calsfu/AutonomousTrike/trike/test/carla_scripts/data/test.png

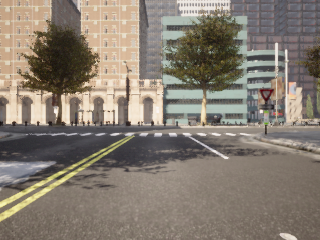
trike/test/carla_scripts/data/test.png
