calsfu/AutonomousTrike/hardware_sup/BrakePicture.png

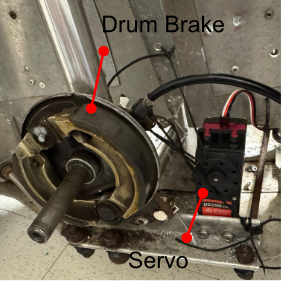
hardware_sup/BrakePicture.png
