calsfu/AutonomousTrike/docs/reports/2nd Semester Prototype Plan.docx

# Memo

To: Professor Pisano

From: Linden Adamson, Jason Calalang, Tara Gill, Zhilang Gui, Cole Resurreccion, Raina Yin

Team: Team 7 - Bike for Blind

Date: 02/22/2025

Subject: Second Prototype Testing Plan

Boston University

Electrical & Computer Engineering

EC464 Senior Design Project

Second Prototype Testing Plan Report

Blind Bike


By

Team 7

Bike for Blind

Team Members

Linden Adamson lindena@bu.edu

Jason Calalang jasonc16@bu.edu

Tara Gill taragill@bu.edu

Zhilang Gui zgui@bu.edu

Cole Resurreccion coler@bu.edu

Raina Yin ryin2@bu.edu

Required Materials/Equipment

Hardware:

- Jetson Orin Nano Super Developer Kit
- OAK-D RGBD Camera
- LED Strips - Brake Lights (5V, 8W)
- 2x DS5160 60 kg*cm Servo Motor
- PCA9685 Motor Driver
- NFP-36GP-555-EN 24V Geared Motor
- DC Motor Driver L298 Dual H Bridge Motor
- 19V 4.2A Barrel Jack Power Supply
- Arduino Uno R3
- Arduino Nano
- Keysight E36318 Triple Output Power Supply
  - 6V for braking
  - 24V for steering

Software:

- Arduino Code
  - Steering script - flashed to Arduino Nano
  - Brake and Key Fob script- flashed to Arduino Uno
- Emergency Stop with Stereo Camera Demo
- Manual Stop Button
- Orin Nano ROS2 Nodes
  - Keyboard Operation (for control)
  - Braking Command
  - Steering Command
  - OAK-D ROS2 Nodes
  - Vectornav

Set-Up

First, every component must be wired according to the diagram below.

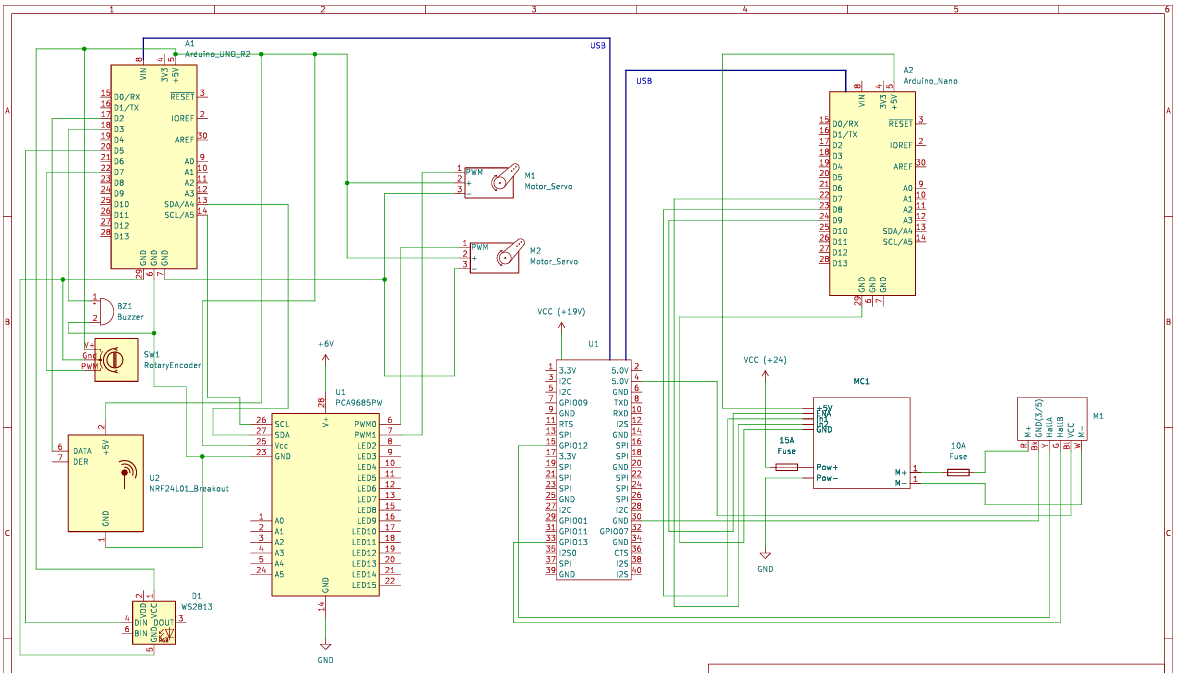
[picture p5: figure]

Figure 1: Circuit Schematic of Prototype System

Once all the components are appropriately connected, ensure no exposed wires are making contact with the aluminum frame to cause a short. After confirming connections, provide power to the necessary components.

- Arduino Nano and Uno should be getting power from the USBs provided by the Orin.
- Connect the 6V output from the power supply to the PCA9685 servo driver.
- Connect the higher voltage output from the power supply to the motor controller and set the output to 24V.
- Power the Orin with the 19V barrel jack plug.
- The LED strip should be powered from the 5V pin on the Arduino.
- The OAK-D should be powered from an Orin USB port.

For proper braking tests, at least one of the DS5160 servo motors should be mounted and attached to the trike.

For the braking system test, the Arduino Uno will be connected to the Jetson Orin. The LED strips and PCA9685 motor driver will be connected to the Arduino Uno. The DS5160 servo motors will both be connected to the PCA9685 motor driver, with one servo motor mounted onto the trike’s brake pad.

For the key fob, a 433MHz RF receiver and a 96dB Piezo buzzer will be connected to the Arduino Uno.

For the steering system, a belt loop should be connected to the main steering joint and the motor output shaft. The NFP should be plugged into the controller and the encoder output should be attached to the Arduino.

For object detection, an OAK-D camera will be mounted onto the trike and connected to the Orin.

Pre-testing Setup Procedure:

On Orin Nano:

1. Open four terminals on the Orin Nano. Run the following commands on those terminals.
  a. ros2 run tester key_op
  b. ros2 launch trike main_launch.py
  c. ros2 run tester emergency_stop
  d. rqt

Power Supply

1. Set the +/-24 V Output of the power supply to +24 V.
2. Set the 6V Output of the power supply to 6V

Testing Procedure:

The testing procedure should mimic a person using the trike.

1. Stand 10m away from the trike and use the keyfob by pressing RF button transmitter and hearing the sound from the buzzer to find the trike.
2. On the keyboard operation terminal:
  a. Type the character s. The brakes should engage and the LED brake lights should turn on.
  b. Type the character w. The brakes should disengage and the LED brake lights should turn off.
  c. Type the character j. The steering motor should turn left.
  d. Type the character k. The steering motor should stop.
  e. Type the character l. The steering motor should turn right.
3. Activate emergency braking software
  a. Clear OAK-D camera’s sightline of any object 2m or closer. The brakes should not be engaged.
  b. Walk to within 2m of the OAK-D camera. The brakes should engage.
  c. Leave 2m sightline of OAK-D camera. The brakes should disengage.
4. Manual brake
  a. Press the manual brake button on the inside of the vehicle. The brakes should engage.
5. Repeat each of the above testing procedures 5 times to prove consistent accuracy of our system.

Measurable Criteria

1. Key fob will activate the buzzer at least 10 meters away from the trike with 80% accuracy.
2. Brake lights and brakes engage within 0.1s of receiving brake command from the Orin Nano with 100% accuracy.
3. Brakes will engage when an object is within 2m of OAK-D camera sightline, and disengage when there is no object within 2m of OAK-D camera sightline with 90% accuracy.
4. Manual brake button will engage the brakes with 100% accuracy. The system should confirm full brake engagement within 0.2 second. It should also override the braking command from the emergency brake.
5. Brake servo motors rotate enough to engage the brake pad with 100% accuracy. The response time should not exceed from command issuance to brake engagement must not exceed 0.2 second.
6. The steering motor will rotate in response to the motor command from the Orin, and the rotation angle must match the command input within the tolerance of 2 degrees to ensure accurate steering.
7. The steering motor restricts itself to rotate within a 60-degree range.

Senior Design ENG EC 464
