calsfu/AutonomousTrike/docs/schematics/Trike HW_SW.drawio.png

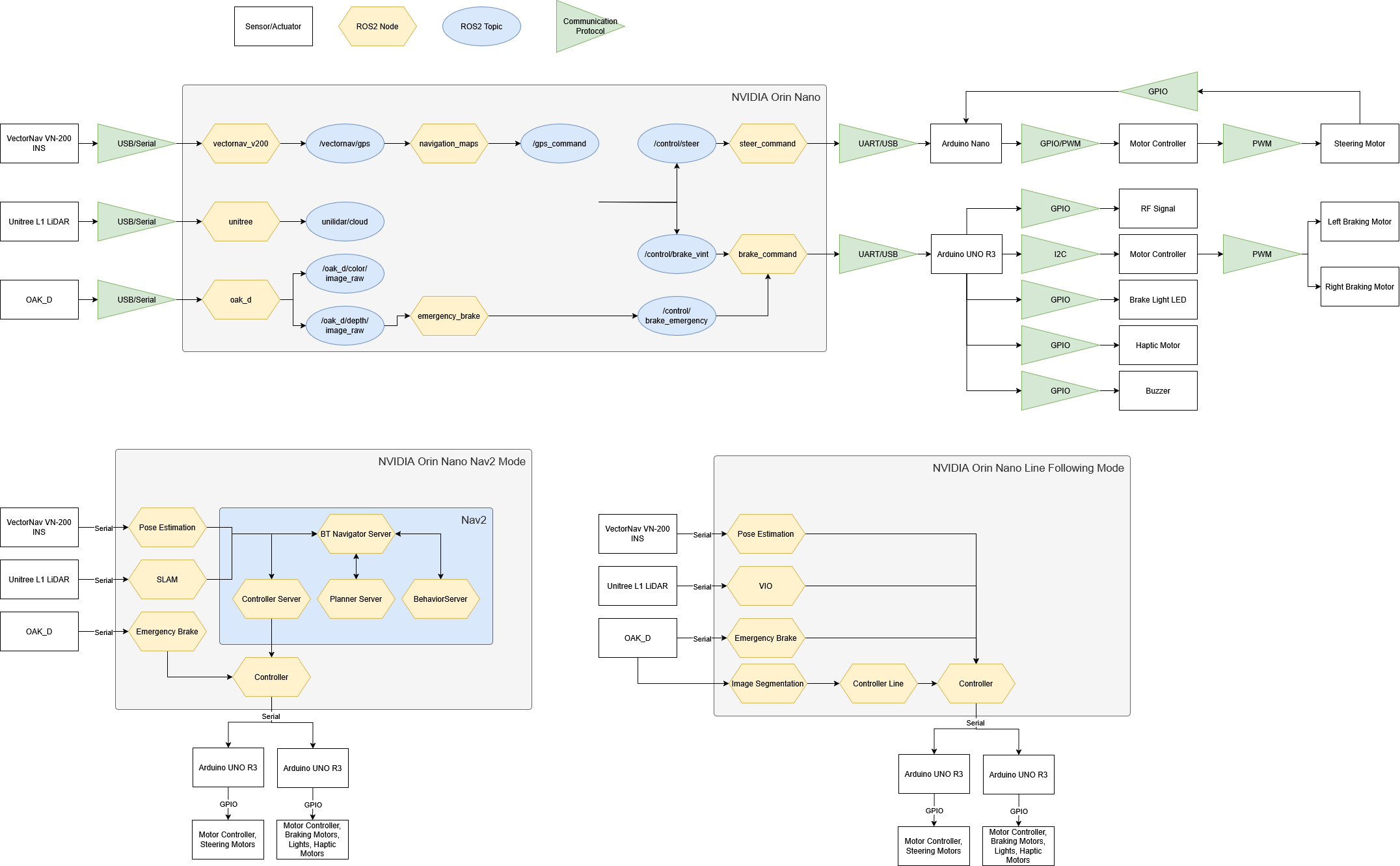
docs/schematics/Trike HW_SW.drawio.png
