calsfu/AutonomousTrike/hardware_sup/EnclosurePicture.jpg

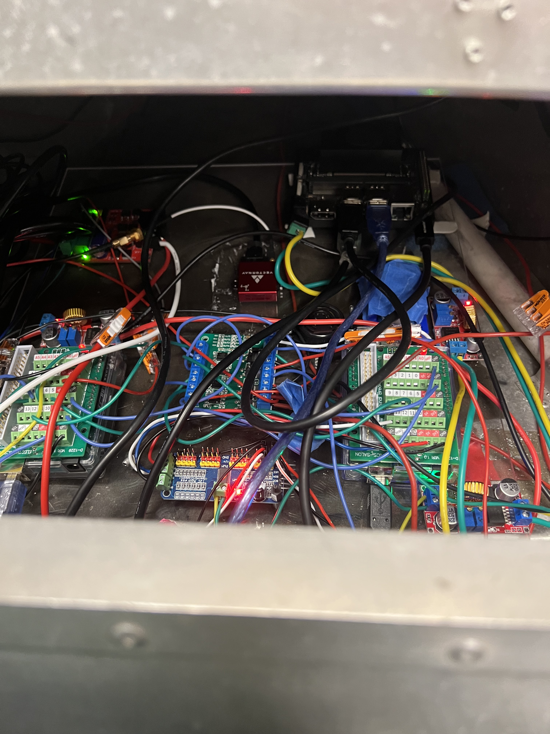
hardware_sup/EnclosurePicture.jpg
