calsfu/AutonomousTrike/hardware_sup/MotorPicture.png

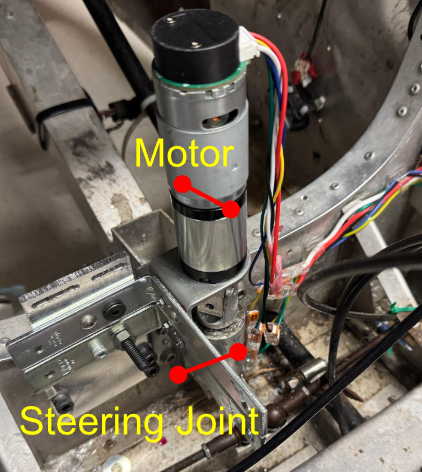
hardware_sup/MotorPicture.png
