calsfu/AutonomousTrike/trike/map/earth_left_turn.png

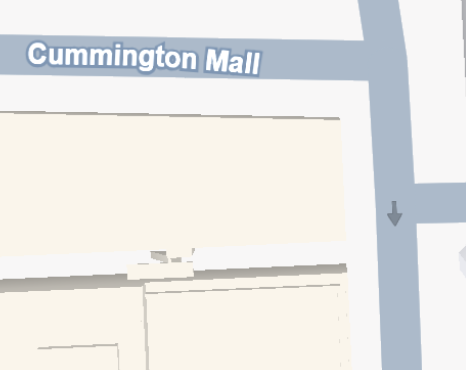
trike/map/earth_left_turn.png
