calsfu/AutonomousTrike/trike/map/pho_to_stuvi_mplt.png

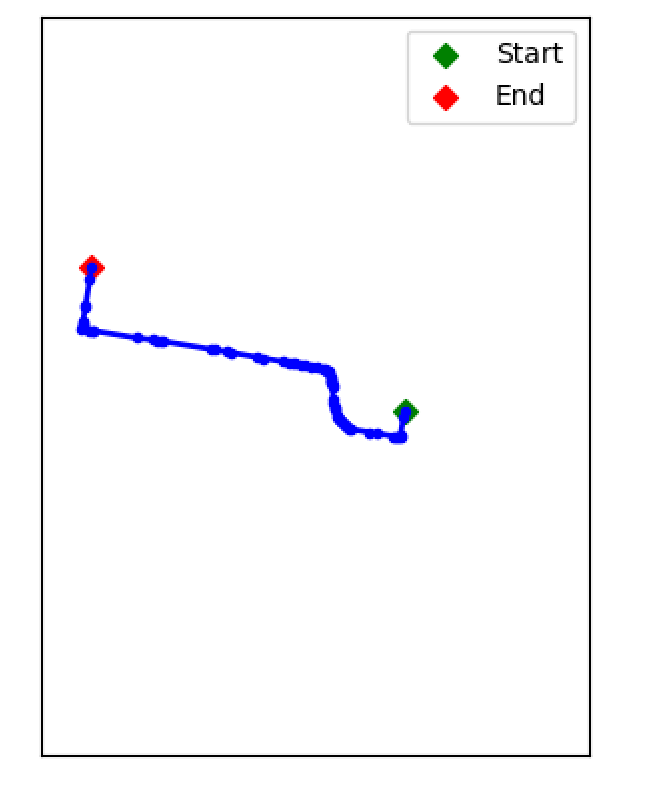
trike/map/pho_to_stuvi_mplt.png
