calsfu/AutonomousTrike/trike/map/pho_to_stuvi_osrm.png

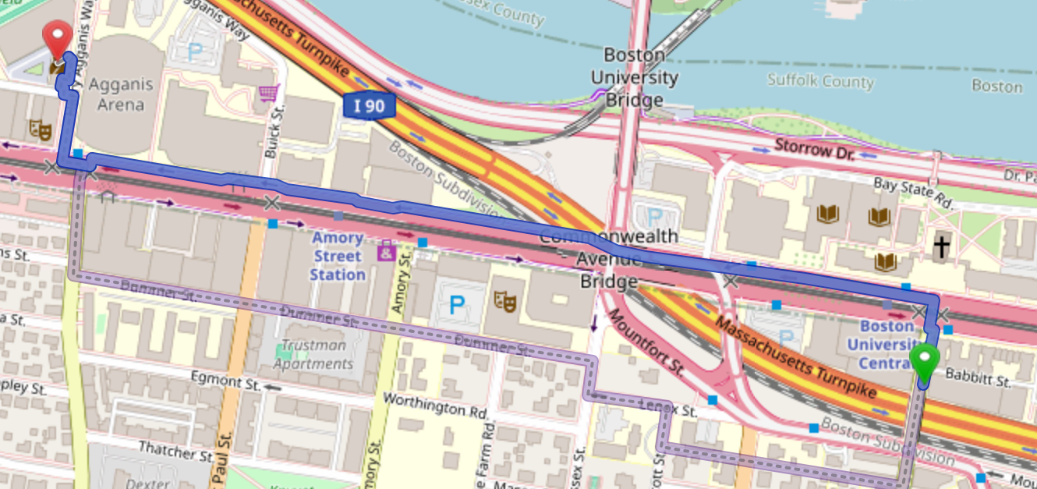
trike/map/pho_to_stuvi_osrm.png
