calsfu/AutonomousTrike/trike/map/segmented_left_turn.png

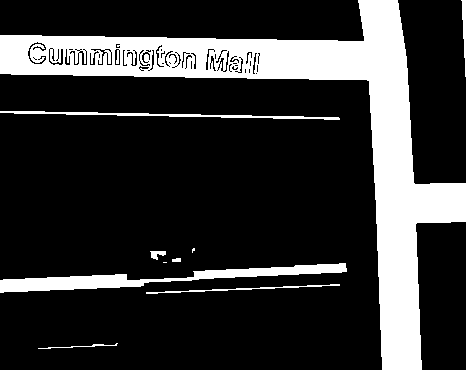
trike/map/segmented_left_turn.png
