calsfu/AutonomousTrike/hardware_sup/ShaftCollar.SLDPRT

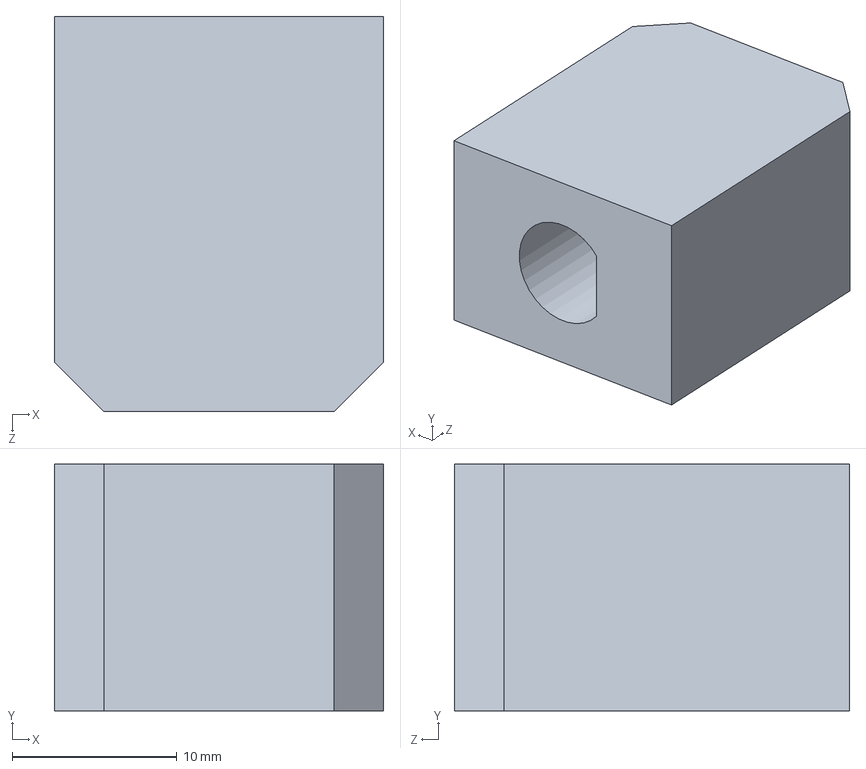
[picture p15: CAD file, 2025-04-28]
hardware_sup/ShaftCollar.SLDPRT
20.0 x 15.0 x 24.0 mm
