calsfu/AutonomousTrike/hardware_sup/SteeringMount.SLDPRT

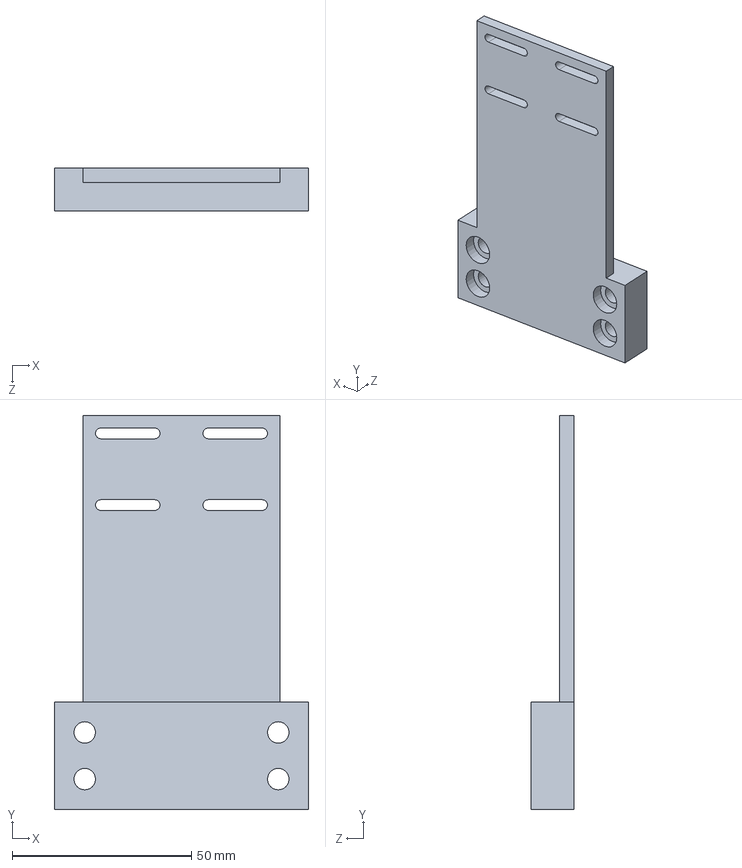
[picture p16: CAD file, 2025-04-28]
hardware_sup/SteeringMount.SLDPRT
71.0 x 110.0 x 12.0 mm
