calsfu/AutonomousTrike/hardware_sup/AssembledSystem.png

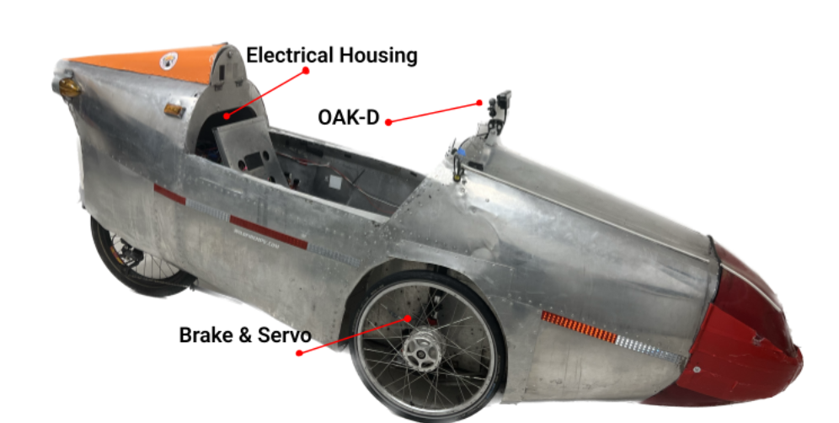
hardware_sup/AssembledSystem.png
