calsfu/AutonomousTrike/hardware_sup/WiringSchematic.pdf

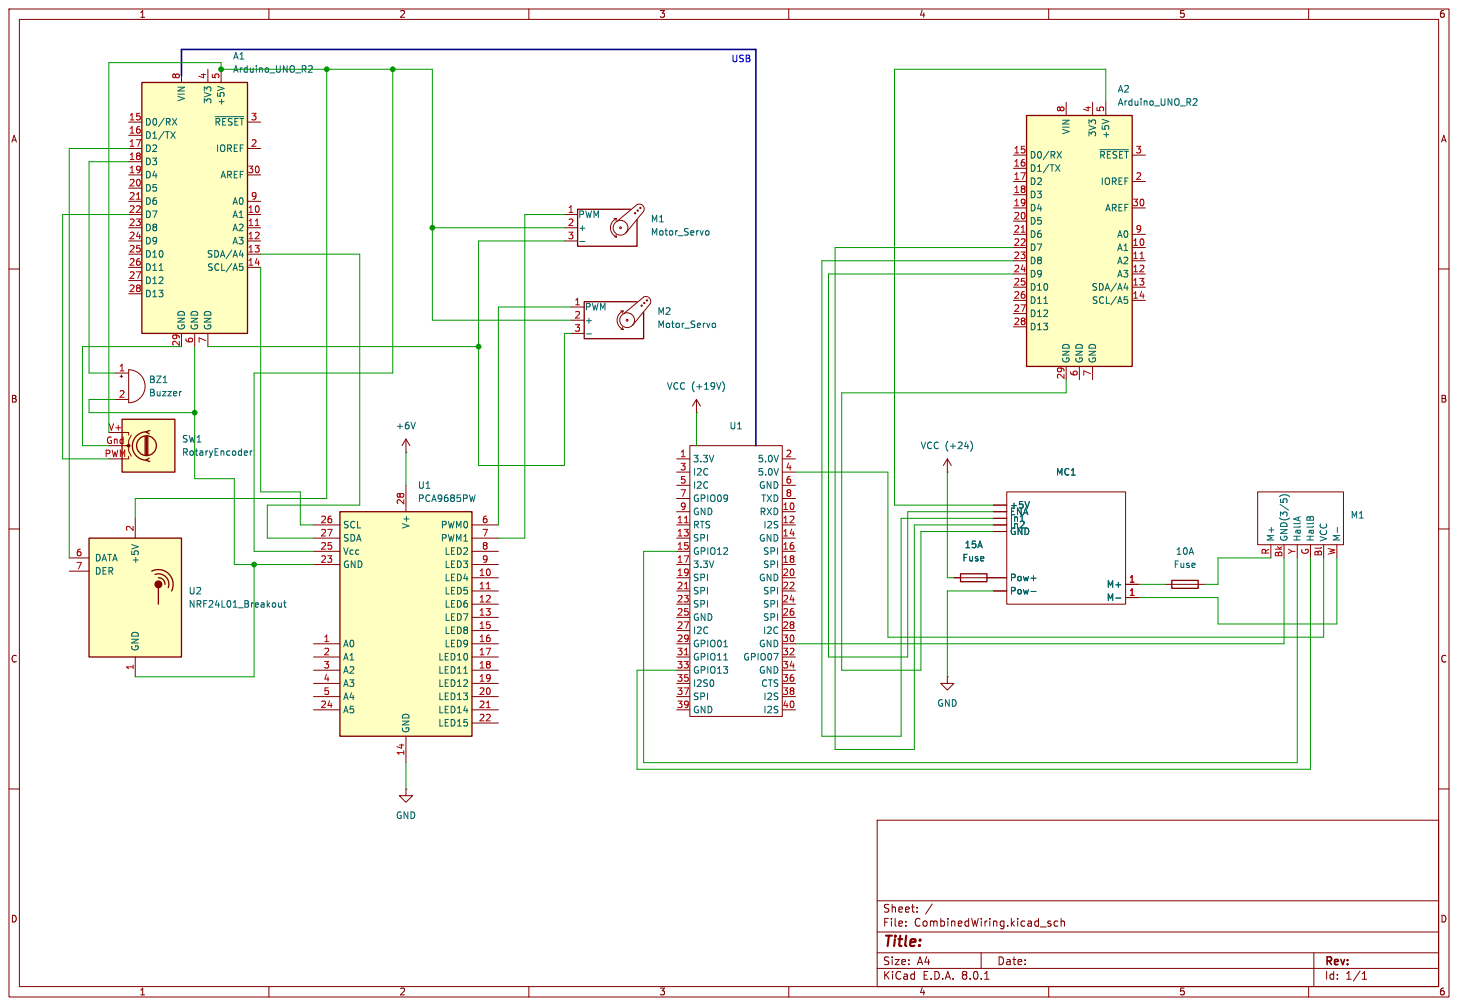
[picture p20: page 1]

Id: 1/1 Title: File: CombinedWiring.kicad_sch Sheet: / Gnd PWM
