calsfu/AutonomousTrike/hardware_sup/SteeringMountSketch.pdf

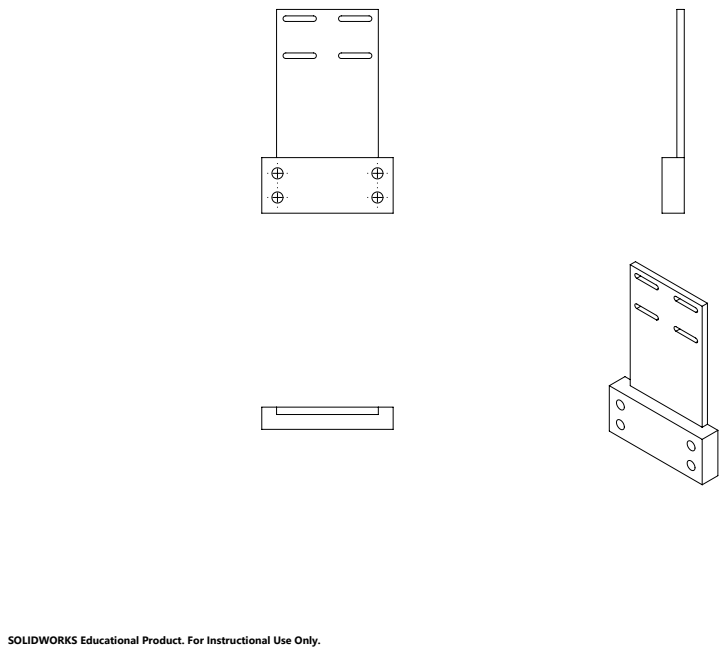
[picture p21: page 1]

SOLIDWORKS Educational Product. For Instructional Use Only.
