calsfu/AutonomousTrike/docs/schematics/CombinedWiring.kicad_sch

## KiCad design docs/schematics/CombinedWiring.kicad_sch (2025-04-28)

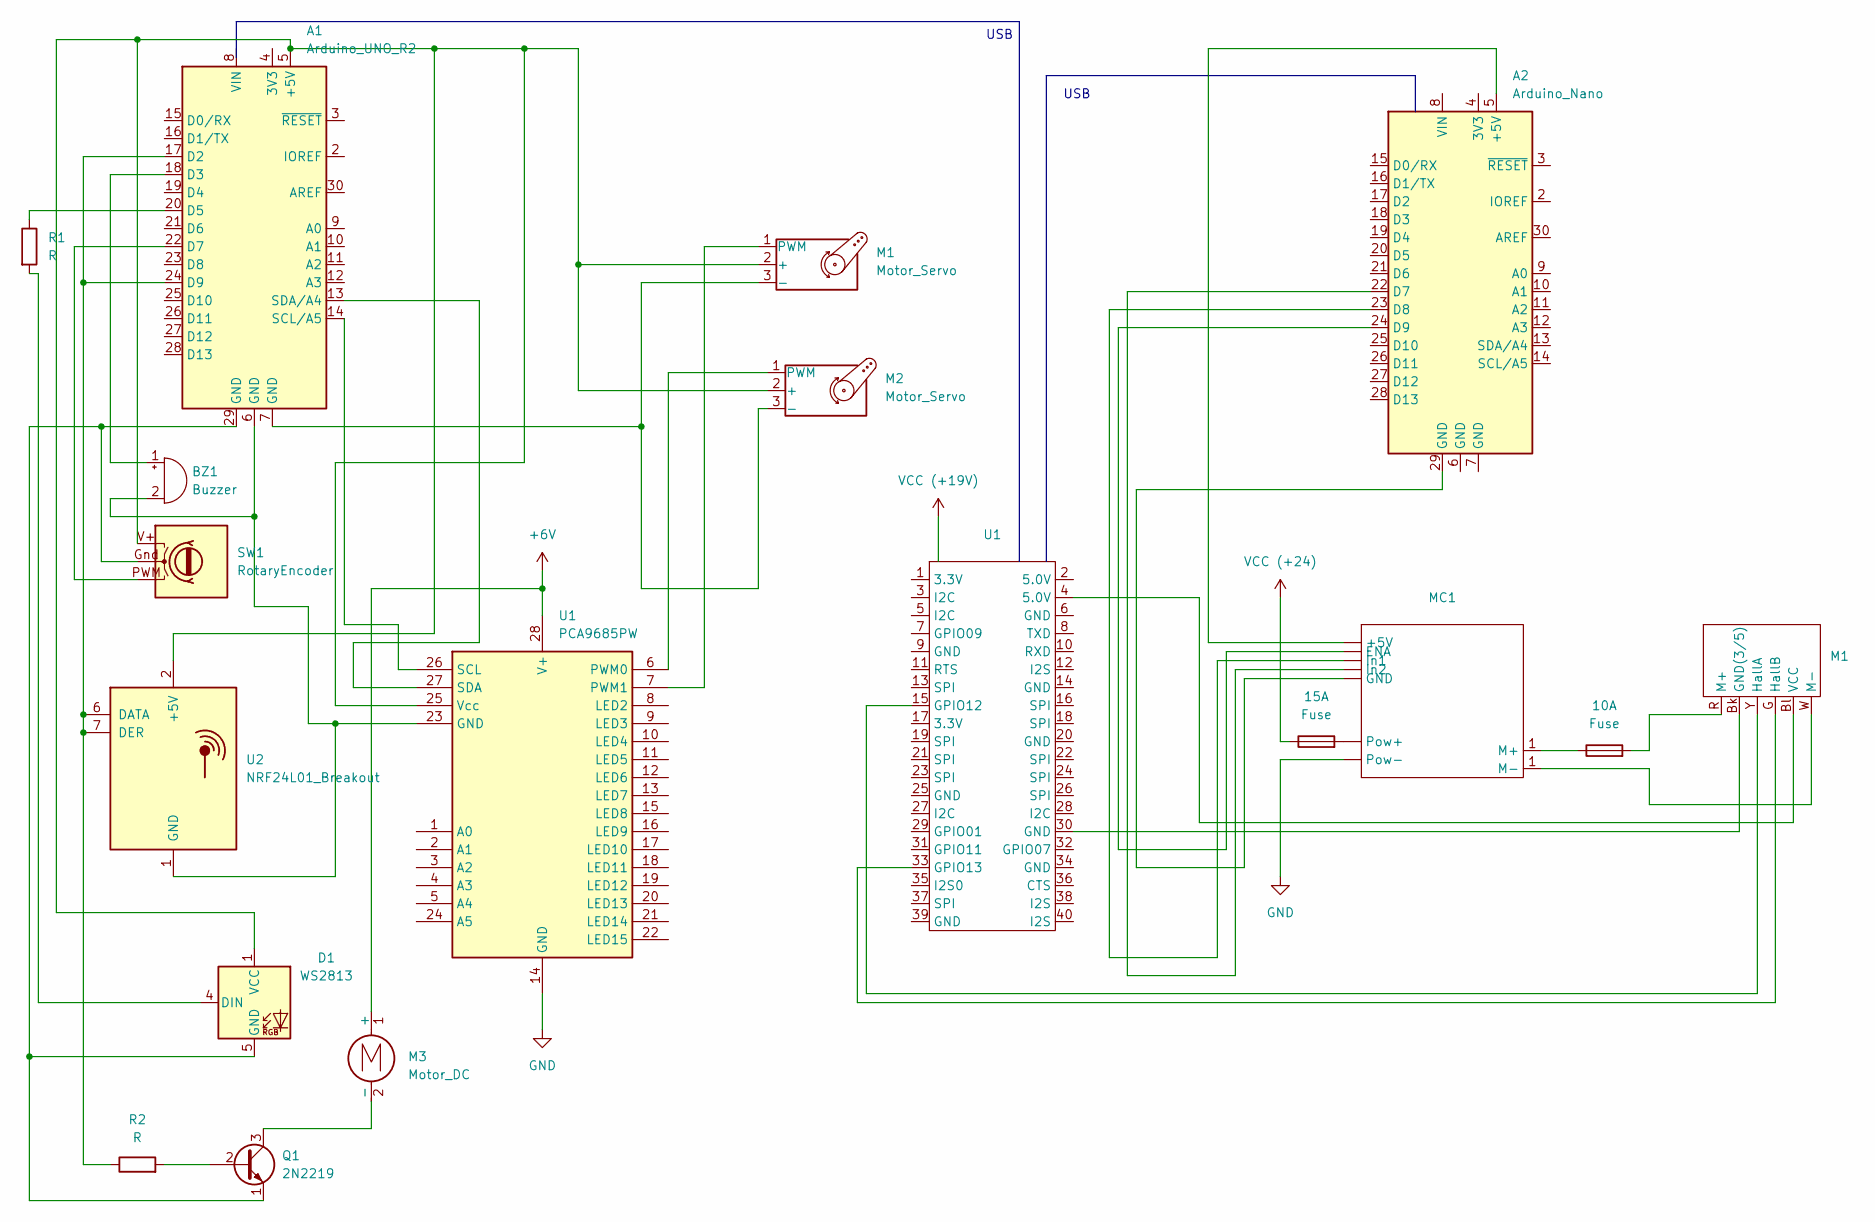
[picture p22: schematic CombinedWiring.kicad_sch]

Parts:
10A, 15A: Fuse
A1: Arduino_UNO_R2
A2: Arduino_Nano; Arduino_UNO_R2
BZ1: Buzzer
D1: WS2813; LED_WS2812_PLCC6_5.0x5.0mm_P1.6mm
M1: (no value)
M2: Motor_Servo
M3: Motor_DC
MC1: (no value)
Q1: 2N2219; TO-39-3
R1, R2: R
SW1: RotaryEncoder
U1: PCA9685PW; TSSOP-28_4.4x9.7mm_P0.65mm
U2: NRF24L01_Breakout; nRF24L01_Breakout

Connections:
+6V: M3.1 (+), U1.28 (I2C)
GND: MC1. (+5V), U1.14 (GND)
unnamed: 10A.1, MC1.1 (M+)
unnamed: 10A.2, M1.R (M+)
unnamed: 15A.2, MC1. (+5V)
unnamed: A1.5 (+5V), D1.1 (VCC), M1.2 (+), M2.2 (+), SW1.V+, U1.25 (GND), U2.2 (+5V)
unnamed: A1.6 (GND), BZ1.2 (-), U1.23 (SPI), U2.1 (GND)
unnamed: A1.7 (GND), M1.3 (-), M2.3 (-)
unnamed: A1.13 (SDA/A4), U1.27 (I2C)
unnamed: A1.14 (SCL/A5), U1.26 (SPI)
unnamed: A1.17 (D2), A1.24 (D9), R2.1, U2.6 (DATA), U2.7 (DER)
unnamed: A1.18 (D3), BZ1.1 (+)
unnamed: A1.20 (D5), R1.1
unnamed: A1.22 (D7), SW1.PWM (B)
unnamed: A1.29 (GND), D1.5 (GND), Q1.1 (E), SW1.Gnd
unnamed: A2.5 (+5V), MC1. (+5V)
unnamed: A2.22 (D7), MC1. (+5V)
unnamed: A2.23 (D8), MC1. (+5V)
unnamed: A2.24 (D9), MC1. (+5V)
unnamed: A2.29 (GND), MC1. (+5V)
unnamed: D1.4 (DIN), R1.2
unnamed: M1.1 (PWM), U1.7 (GPIO09)
unnamed: M1.Bk (GND(3/5)), U1.30 (GND)
unnamed: M1.Bl (VCC), U1.4 (5.0V)
unnamed: M1.G (HallB), U1.33 (GPIO13)
unnamed: M1.W (M-), MC1.1 (M+)
unnamed: M1.Y (HallA), U1.15 (GPIO12)
unnamed: M2.1 (PWM), U1.6 (GND)
unnamed: M3.2 (-), Q1.3 (C)
unnamed: Q1.2 (B), R2.2
VCC (+24): 15A.1

Notes on the sheet:
USB
