calsfu/AutonomousTrike/(commit log)

2024-11-15 Added motor control and some keyboard command
2024-11-17 Created PID controller with node for line following
2024-11-19 realsense src code
    [_d405.urdf.xacro, _d415.urdf.xacro, _d435.urdf.xacro, _d435i.urdf.xacro, _d435i_imu_modules.urdf.xacro, _d455.urdf.xacro, _materials.urdf.xacro, _r410.urdf.xacro]
2024-11-19 update on SOC2 driver
2024-12-07 ViNT files with important changes
    [robot.yaml]
2024-12-09 Moved folders around
    [robot.yaml]
2025-02-10 Moved src out of ros2_ws
    [_d405.urdf.xacro, _d415.urdf.xacro, _d435.urdf.xacro, _d435i.urdf.xacro, _d435i_imu_modules.urdf.xacro, _d455.urdf.xacro, _materials.urdf.xacro, _r410.urdf.xacro]
2025-02-11 Connected Orin to Arduino through servo_controller node
2025-02-11 Added Arduino folder and updated code to fit with Orin
2025-02-11 python steering motor code
2025-02-11 update python motor control
2025-02-18 Added buzzer to braking code, added steering arduino code
    [steering_unit.cpp]
2025-02-18 Added steering motor ros2 node and updated tester node
2025-02-22 Added depthai ros2 nodes
    [OAK-D-SR-POE.stl, base_descr.urdf.xacro, base_macro.urdf.xacro, calibration.yaml, depthai_descr.urdf.xacro, depthai_macro.urdf.xacro]
2025-02-22 Removed realsense code
    [_d405.urdf.xacro, _d415.urdf.xacro, _d435.urdf.xacro, _d435i.urdf.xacro, _d435i_imu_modules.urdf.xacro, _d455.urdf.xacro, _materials.urdf.xacro, _r410.urdf.xacro]
2025-02-24 Added launch file for starting motor controls
2025-02-25 Added wait to let arduino boot up before sending commands
2025-02-25 Renamed to .ino and fixed steering with encoder
    [braking_control.ino, key_fob.ino]
2025-03-25 Cleaned up steering control and made braking compatible with 2 leds
2025-04-01 Deleted unused, added demo urdf,
    [velomobile.urdf.xacro]
2025-04-01 build is successful
    [trike.urdf.xacro]
2025-04-08 Added demo urdf, update cmake, launch, and package files
    [ackerman.urdf, box.urdf.xacro, rover.urdf, rover.urdf.xacro, trike.urdf]
2025-04-08 Updated to use serial numbers of arduino
2025-04-09 updated break and steer
2025-04-09 Added light control to steering
2025-04-09 Added LiDAR without submodule
2025-04-09 Working new description
    [gem.xacro]
2025-04-09 Put steering back to normals
2025-04-10 added urdf
    [ackerman.xacro, ackermanBeforeChange.urdf]
2025-04-18 Update key fob, arduino, launch files
2025-04-23 Added mode switch tests
2025-04-23 Fixed naming, added play_audio.py
    [play_audio.py]
2025-04-24 Removed unused files and directories
    [OAK-D-SR-POE.stl, base_descr.urdf.xacro, base_macro.urdf.xacro, calibration.yaml, depthai_descr.urdf.xacro, depthai_macro.urdf.xacro, robot.yaml, trike.urdf]
2025-04-24 Moved trike out of src
    [ackerman.urdf, ackerman.xacro, ackermanBeforeChange.urdf, box.urdf.xacro, gem.xacro, rover.urdf, rover.urdf.xacro, trike.urdf]
2025-04-24 Removed old steering
2025-04-27 Added wiring diagram
2025-04-28 first upload of hardware files (1/2)
    [ShaftCollar.SLDPRT, SteeringMount.SLDPRT]
2025-04-29 Added speech_to_text and fixed mode_manager
    [mode_manager.py, speech_to_text.py]
2025-04-30 (mostly) working on the orin, missing ROS2
    [config.yaml]
