calsfu/AutonomousTrike/trike/images/IMG_2129.JPG

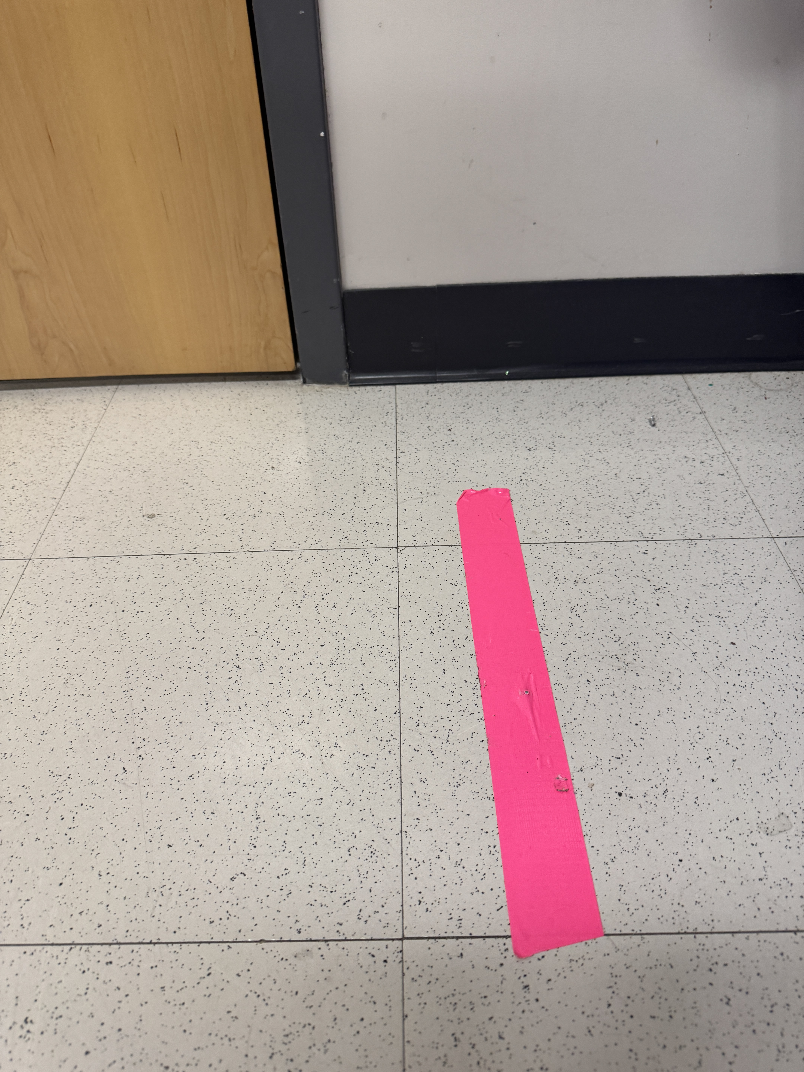
trike/images/IMG_2129.JPG
