calsfu/AutonomousTrike/trike/images/IMG_2130.JPG

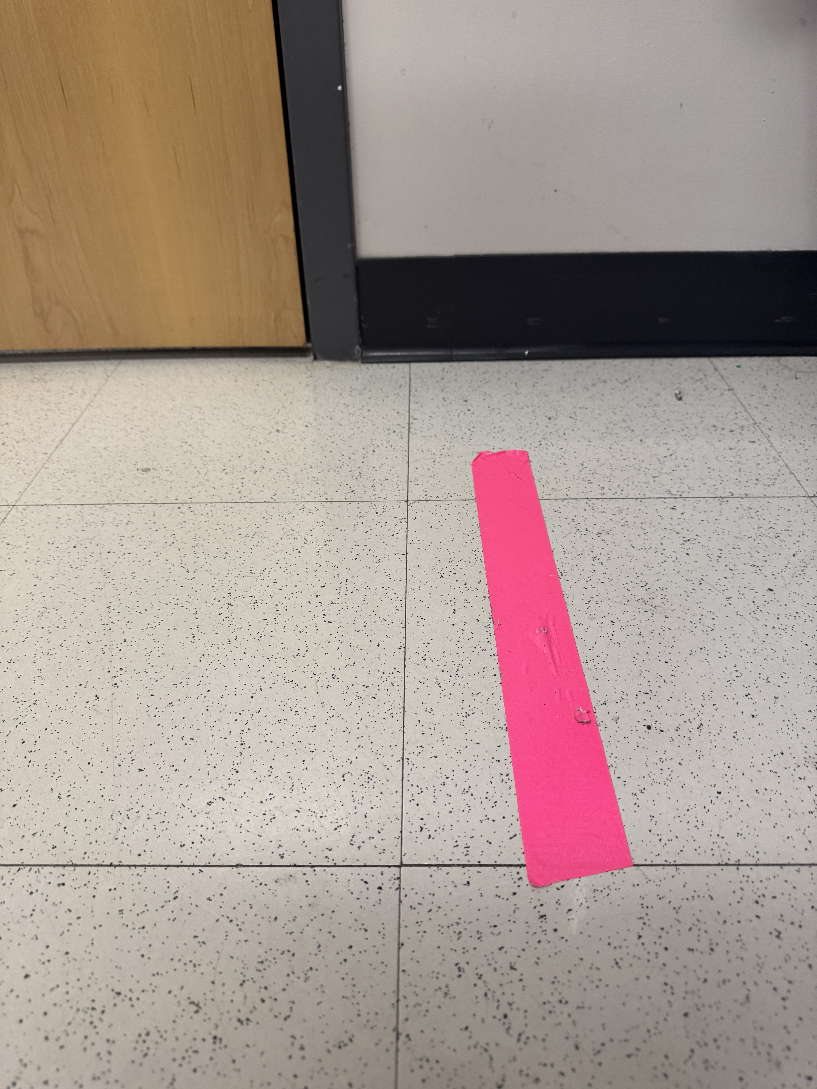
trike/images/IMG_2130.JPG
